atonizzo/kicad_library/README.md

# kicad_library

The following varfiables must be defined:

$KIMY3DMOD
Points to the 3D models of the devices.

$KIMYMOD
Points to the footprints.

$KISYSSYMB
Points to the symbols.
