atonizzo/kicad_library/(commit log)

2019-10-22 Removed footprint for ATtinyx5 since it comes in 2 packages.
2020-01-31 Added 1x3 header connector.
2020-06-11 Fixed a problem with On Semi DSN2 footprint.
2020-11-28 Modified the LED symbol name.
